kopallusneha/suntime/README.md

# suntime
<<<<<<< HEAD
suntime files
=======
an automatic switch for lamps
>>>>>>> 56ceb3c0a73d5a83d8082f83b8aa1d36cf2738f9
